mardicas/ballmer_peak_machine/(list of files, drawings)

Other design files:
wiring.fzz
