mardicas/ballmer_peak_machine/(commit log)

2019-05-03 Add schematics
    [wiring.fzz]
2019-05-03 Add resistors to schema
    [wiring.fzz]
2019-05-03 Improve schematic placements
    [wiring.fzz]
2019-05-03 Improve diagrams
    [wiring.fzz]
2019-05-03 Inform of 300ohm on LED.
